AlfredoSystems/I3ESC-Hardware/I3ESC-pdfs/I3ESC.pdf

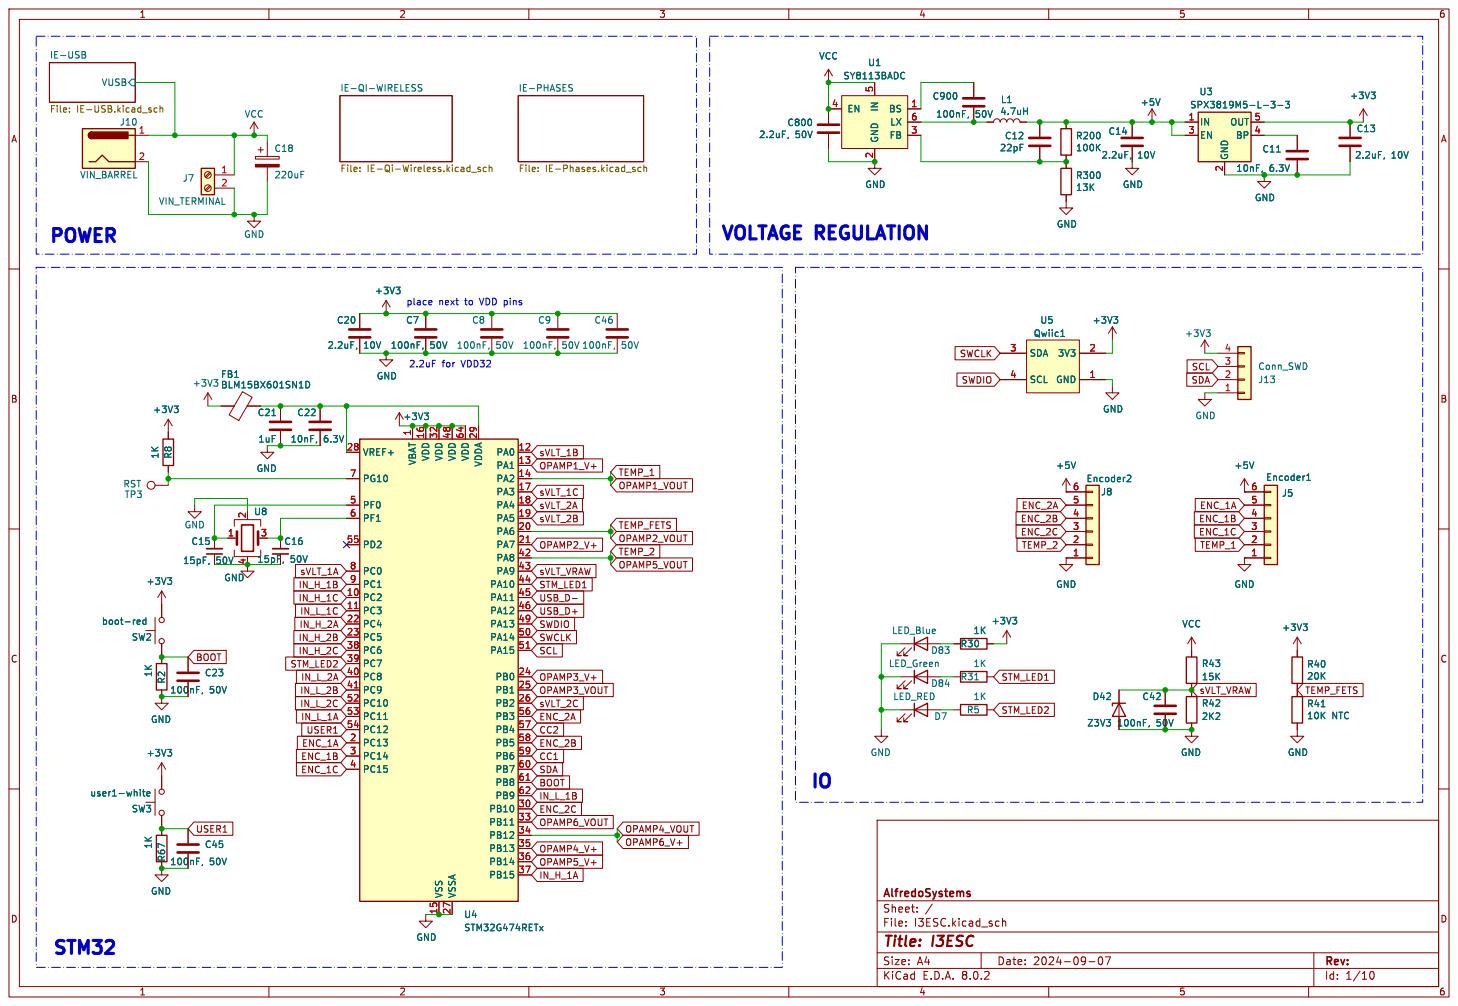
[picture p1: page 1]

File: IE-Phases.kicad_sch VUSB

File: IE-Qi-Wireless.kicad_sch

- change wireless chips to 0603 POWER

1 PC2 10 PC3 11 PA0 12 PA1 13 PA2 14 VSS 15 VDD 16 PA3 17 PA4 18 PA5 19 PC13 2 PA6 20 PA7 21 PC4 22 PC5 23 PB0 24 PB1 25 PB2 26 VSSA 27 VREF+ 28 VDDA 29 PC14 3 PB10 30 VDD 32 PB11 33 PB12 34 PB13 35 PB14 36 PB15 37 PC6 38 PC7 39 PC15 4 PC8 40 PC9 41 PA8 42 PA9 43 PA10 44 PA11 45 PA12 46 VDD 48 PA13 49 PF0 5 PA14 50 PA15 51 PC10 52 PC11 53 PC12 54 PD2 55 PB3 56 PB4 57 PB5 58 PB6 59 PF1 6 PB7 60 PB8 61 PB9 62 VDD 64 PG10 7 PC0 8 PC1 9 C23

1 PC2 10 PC3 11 PA0 12 PA1 13 PA2 14 VSS 15 VDD 16 PA3 17 PA4 18 PA5 19 PC13 2 PA6 20 PA7 21 PC4 22 PC5 23 PB0 24 PB1 25 PB2 26 VSSA 27 VREF+ 28 VDDA 29 PC14 3 PB10 30 VDD 32 PB11 33 PB12 34 PB13 35 PB14 36 PB15 37 PC6 38 PC7 39 PC15 4 PC8 40 PC9 41 PA8 42 PA9 43 PA10 44 PA11 45 PA12 46 VDD 48 PA13 49 PF0 5 PA14 50 PA15 51 PC10 52 PC11 53 PC12 54 PD2 55 PB3 56 PB4 57 PB5 58 PB6 59 PF1 6 PB7 60 PB8 61 PB9 62 VDD 64 PG10 7 PC0 8 PC1 9 U4STM32G474RETx R43

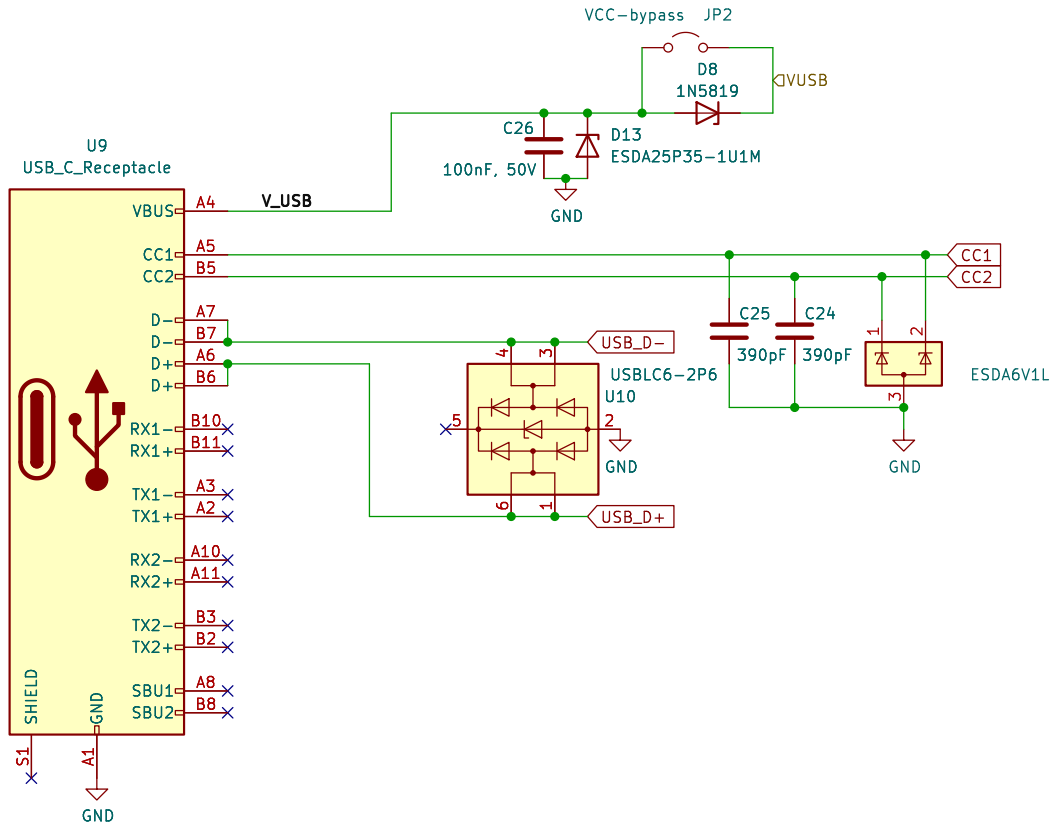
[picture p2: page 2]

File: IE-USB.kicad_sch Sheet: /IE-USB/ AlfredoSystems

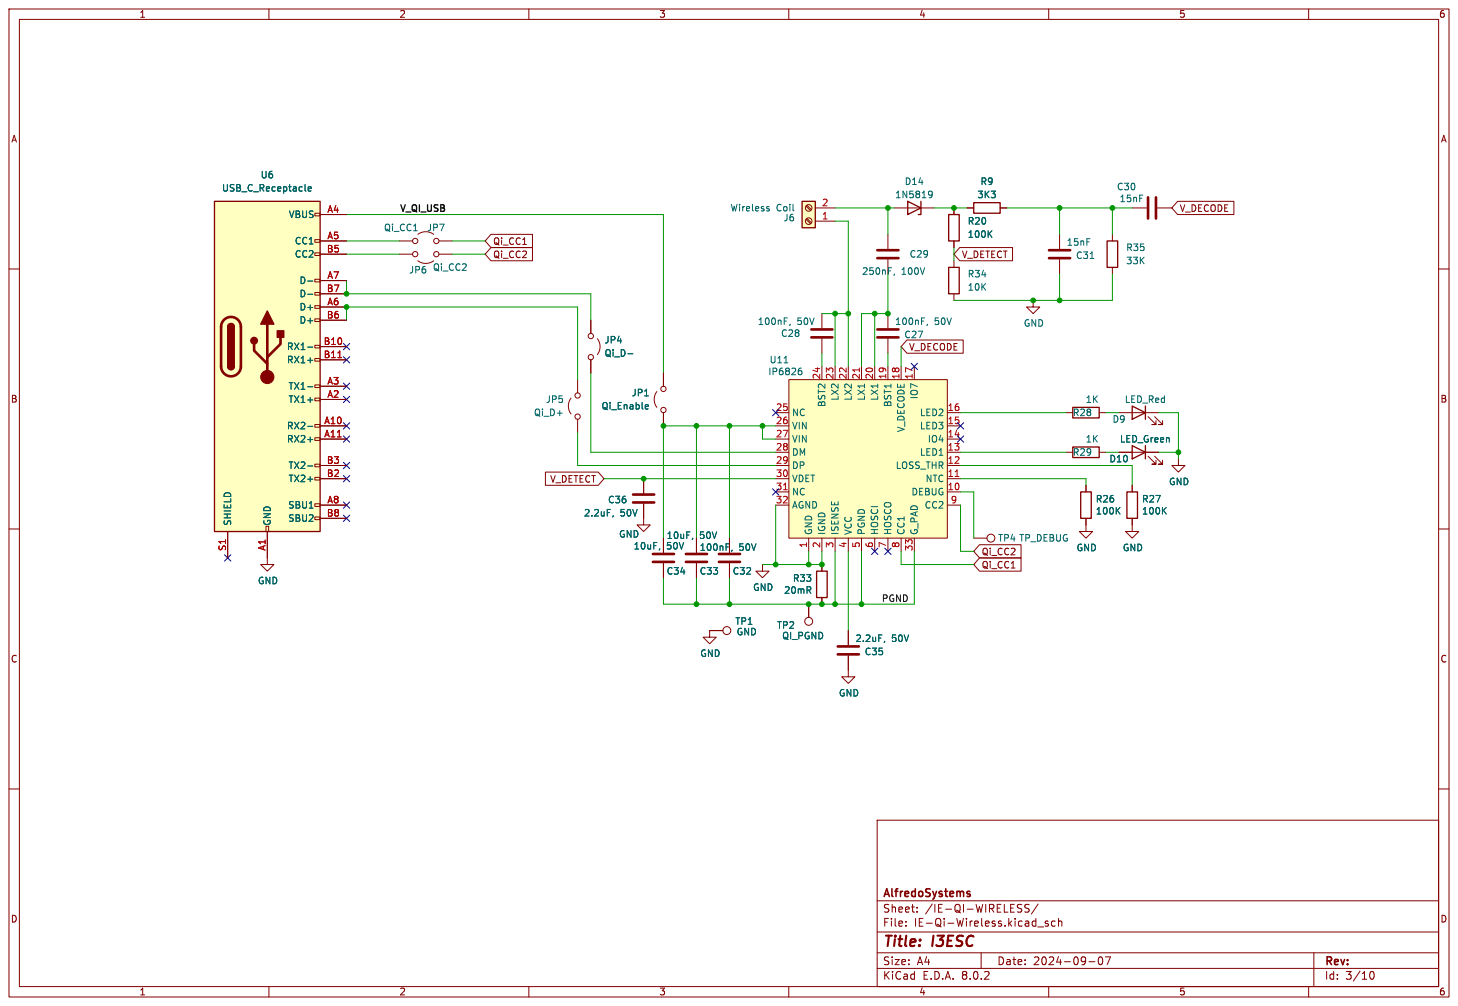
[picture p3: page 3]

2 LX1 20 LX1 21 LX2 22 LX2 23 BST2 24 NC 25 VIN 26 VIN 27 DM 28 DP 29 ISENSE

3 VDET 30 NC 31 AGND 32 G_PAD 33 VCC

AlfredoSystems
File: IE-Qi-Wireless.kicad_sch Sheet: /IE-QI-WIRELESS/
Id: 3/10 Title: I3ESC

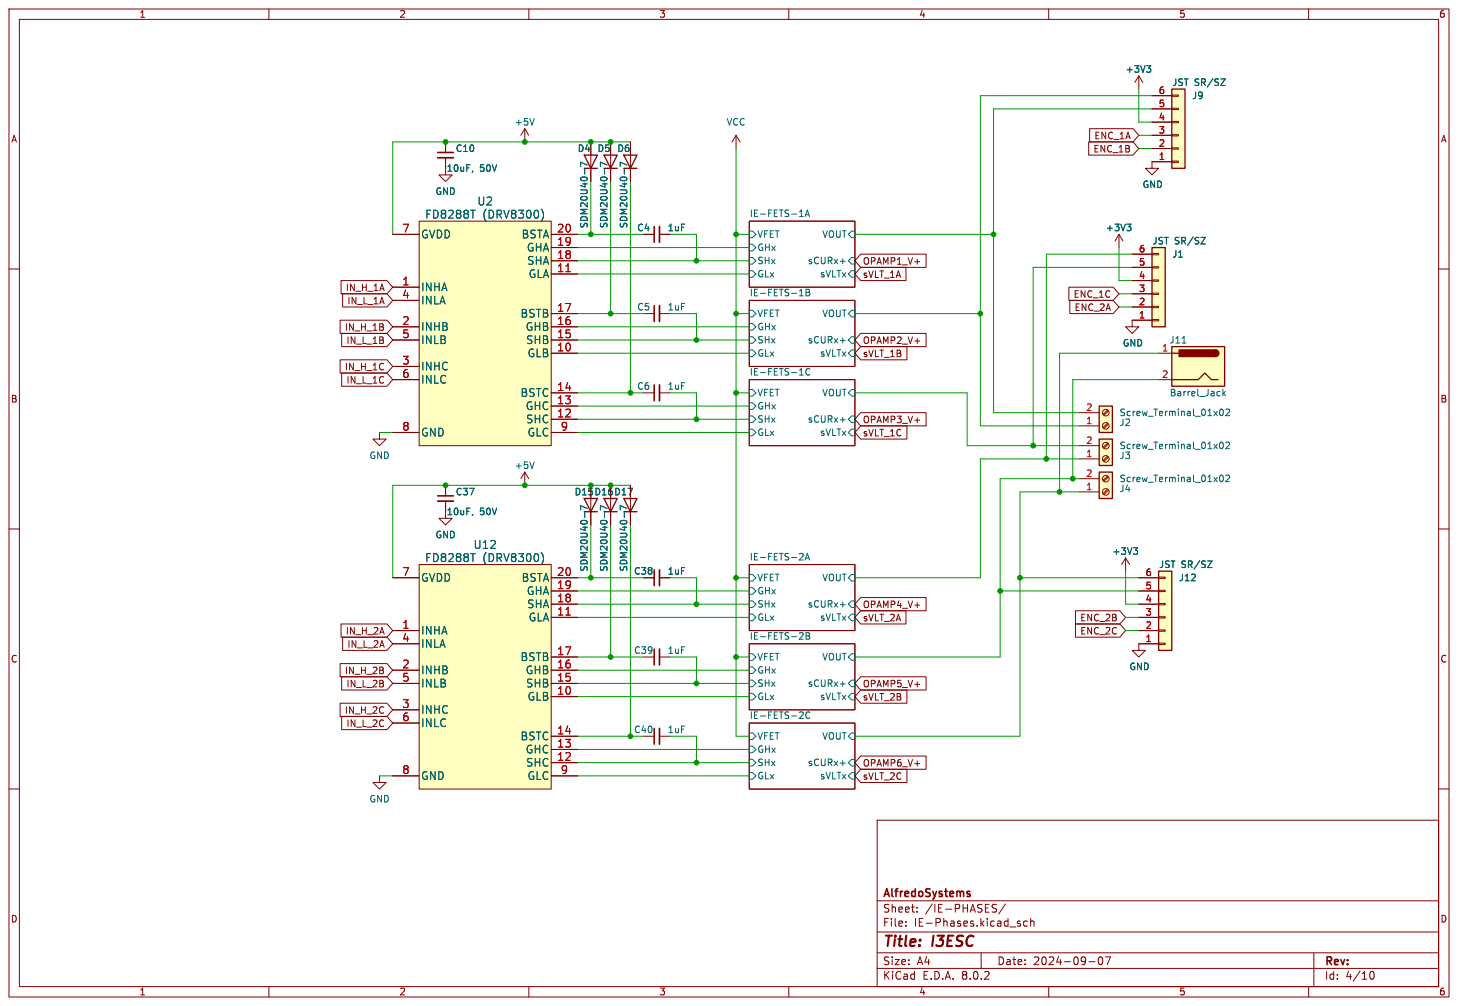
[picture p4: page 4]

JST SR/SZ 123456
JST SR/SZ 123456 GNDGND
JST SR/SZ GND

File: IE-Phases.kicad_sch Sheet: /IE-PHASES/ AlfredoSystems

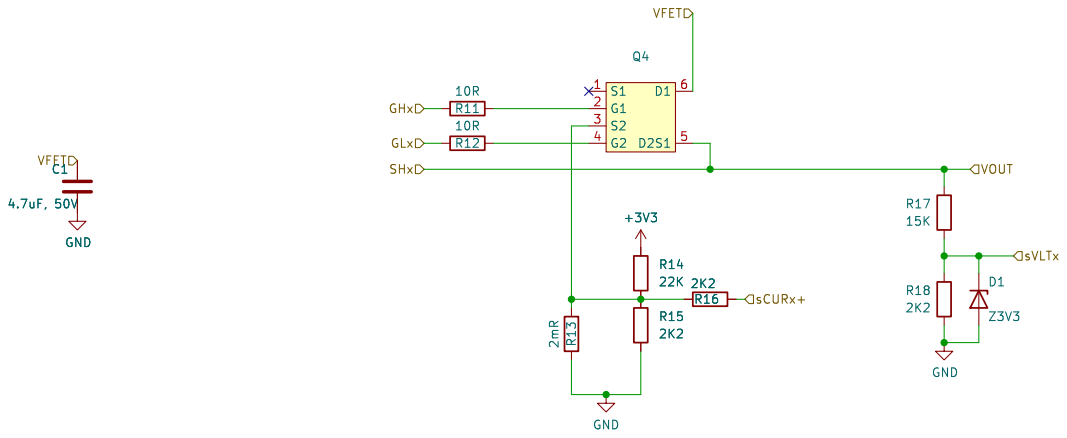
[picture p5: page 5]

File: IE-FETS.kicad_sch Sheet: /IE-PHASES/IE-FETS-1A/ AlfredoSystems R15

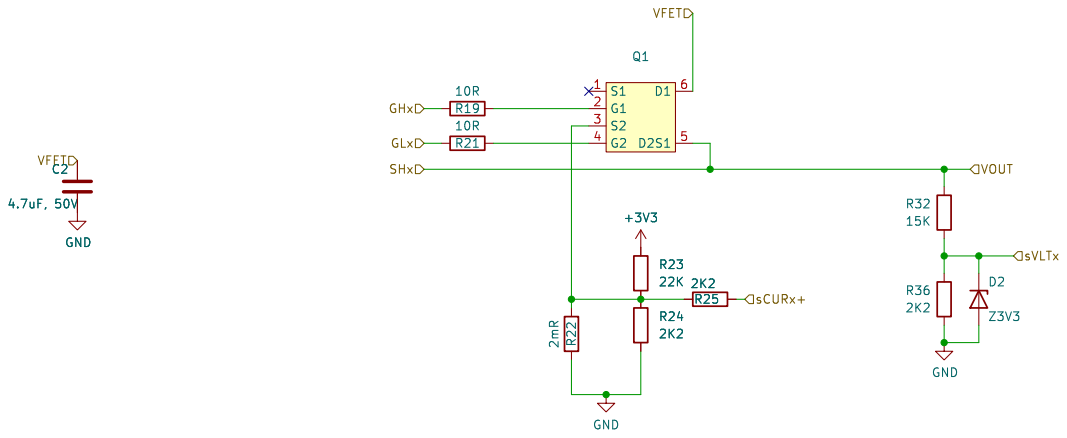
[picture p6: page 6]

File: IE-FETS.kicad_sch Sheet: /IE-PHASES/IE-FETS-1B/ AlfredoSystems R25

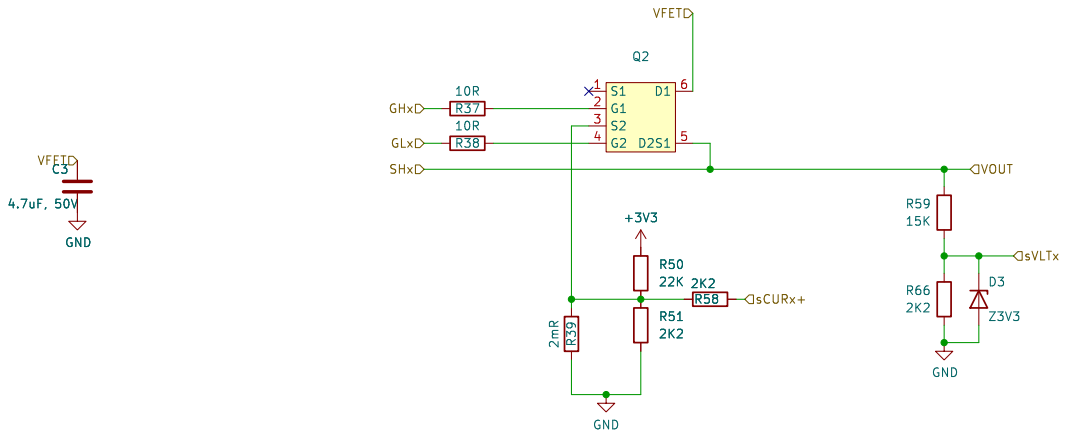
[picture p7: page 7]

File: IE-FETS.kicad_sch Sheet: /IE-PHASES/IE-FETS-1C/ AlfredoSystems

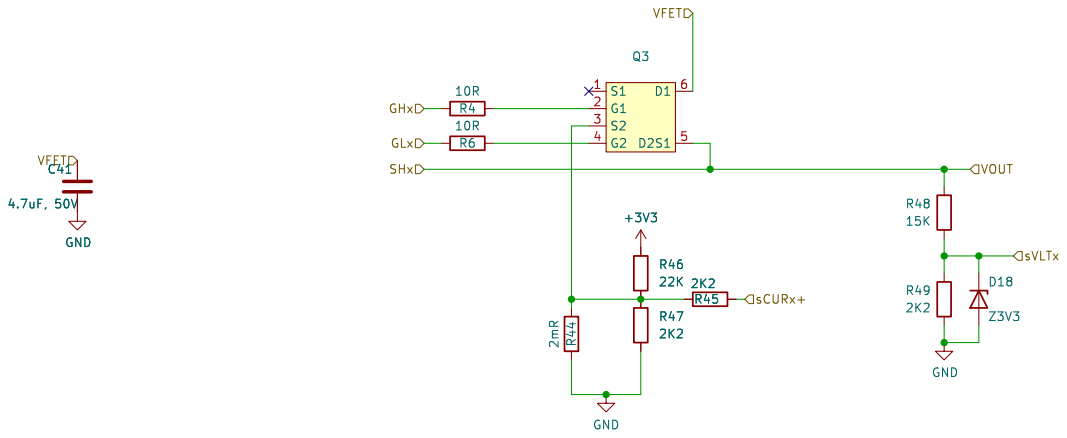
[picture p8: page 8]

File: IE-FETS.kicad_sch Sheet: /IE-PHASES/IE-FETS-2A/ AlfredoSystems R47

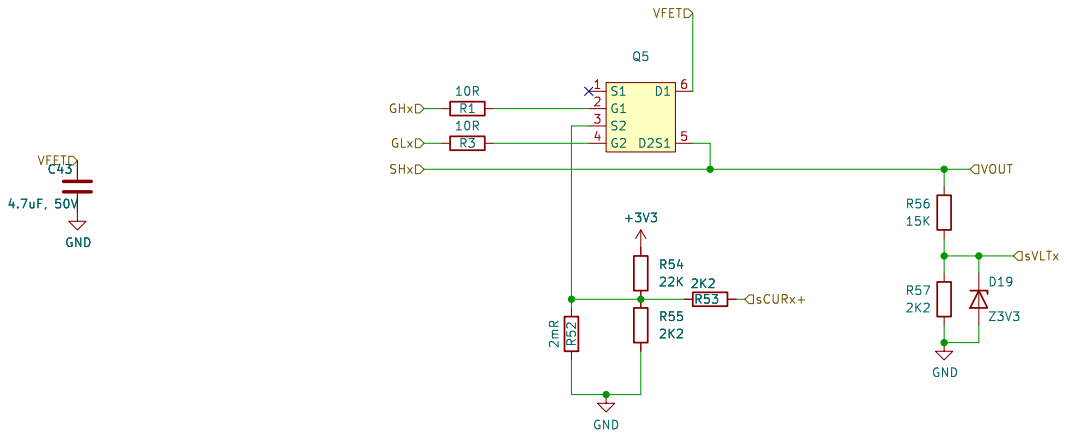
[picture p9: page 9]

File: IE-FETS.kicad_sch Sheet: /IE-PHASES/IE-FETS-2B/ AlfredoSystems R53

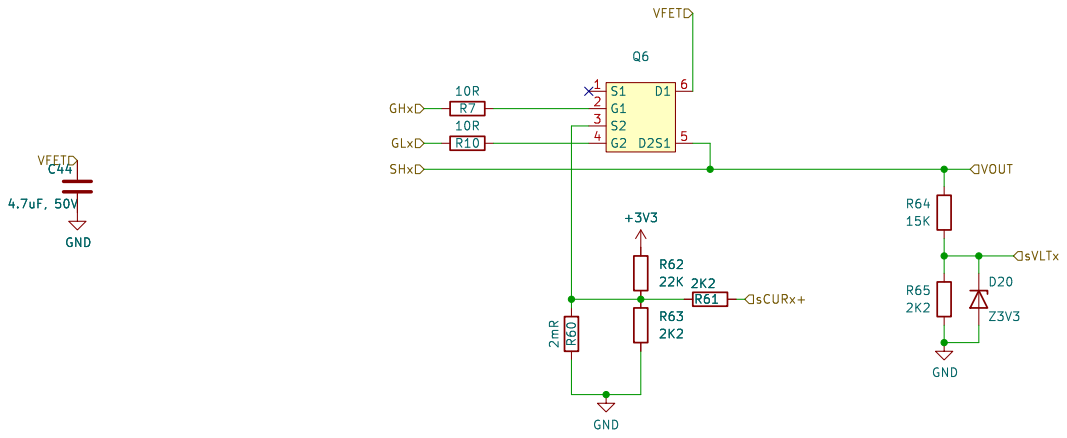
[picture p10: page 10]

File: IE-FETS.kicad_sch Sheet: /IE-PHASES/IE-FETS-2C/ AlfredoSystems
