AlfredoSystems/I3ESC-Hardware/I3ESC.kicad_pcb

## KiCad design I3ESC.kicad_pcb (2026-09-11)

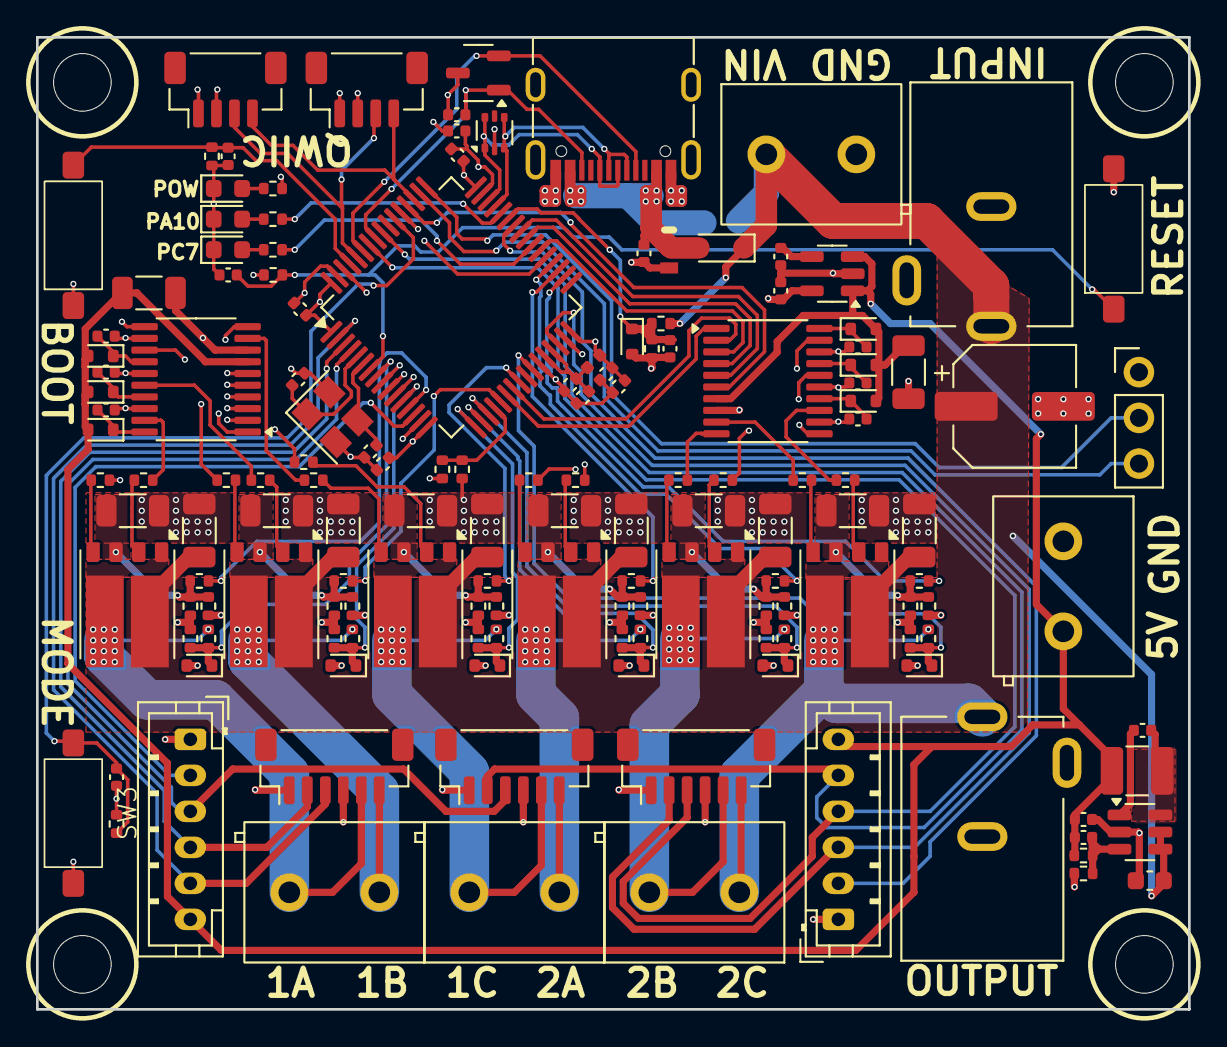
[picture p11: board I3ESC.kicad_pcb from above]

Board: 4 copper layers, 64.0 x 54.0 mm, 155 parts (1 on the bottom side), 104 nets.

Parts:
C1, C2, C3, C41, C43, C44: 4.7uF, 50V; C_1206_3216Metric
C4, C5, C6, C21, C38, C39, C40: 1uF; C_0402_1005Metric
C7, C8, C9, C17, C23, C26, C42, C45, C46, C900: 100nF, 50V; C_0402_1005Metric
C10, C37: 10uF, 50V; C_1206_3216Metric
C11, C22: 10nF, 6.3V; C_0402_1005Metric
C12: 22pF; C_0402_1005Metric
C13, C14, C20: 2.2uF, 10V; C_0402_1005Metric
C15, C16: 15pF, 50V; C_0402_1005Metric
C18: 220uF; CP_Elec_6.3x7.7
C24, C25: 390pF; C_0402_1005Metric
C800: 2.2uF, 50V; C_0603_1608Metric
D1, D2, D3, D18, D19, D20, D42: Z3V3; D_SOD-523
D4, D5, D6, D15, D16, D17: SDM20U40-7; D_SOD-523
D7: LED_RED; LED_0603_1608Metric
D8: 1N5819; D_SOD-323
D11: ESDA6V1L; SOT-23-3
D13: ESDA25P35-1U1M; DFN1610-2
D83: LED_Blue; LED_0603_1608Metric
D84: LED_Yellow; LED_0603_1608Metric
FB1: BLM15BX601SN1D; L_0402_1005Metric
H1, H2, H3, H4: MountingHole; TGD_MountingHole
J1, J9, J12: JST SR/SZ; JST_SH_1x06_Vertical
J2, J3, J4, J6, J7: Screw_Terminal_01x02; TerminalBlock_Ningbo_2P_5mm
J5, J8: Encoder; JST_PH_B6B-PH-K_1x06_P2.00mm_Vertical
J10, J11: VIN_BARREL; DC-005C_1
J13: Conn_01x03; PinHeader_1x03_P2.54mm_Vertical
JP2: VCC-bypass; SolderJumper-2-Small
L1: 4.7uH; L_1210_3225Metric
Q1, Q2, Q3, Q4, Q5, Q6: DFN-8-2EP_6x5mm
R1, R3, R4, R6, R7, R10, R11, R12, R19, R21, R37, R38: 0R; R_0402_1005Metric
R2, R5, R8, R30, R31, R67: 1K; R_0402_1005Metric
R13, R22, R39, R44, R52, R60: 2mR; R_1206_3216Metric
R14, R23, R46, R50, R54, R62: 22K; R_0402_1005Metric
R15, R16, R18, R24, R25, R36, R42, R45, R47, R49, R51, R53, R55, R57, R58, R61, R63, R65, R66: 2K2; R_0402_1005Metric
R17, R32, R43, R48, R56, R59, R64: 15K; R_0402_1005Metric
R40: 20K; R_0402_1005Metric
R41: 10K NTC; R_0402_1005Metric
R200: 100K; R_0402_1005Metric
R300: 13K; R_0402_1005Metric
SW1, SW2, SW3: button; button-3.6x6mm
U1: SY8113BADC; TSOT-23-6
U2, U12: FD8288T (DRV8300); TSSOP-20_4.4x6.5mm_P0.65mm
U3: SPX3819M5-L-3-3; SOT-23-5
U4: STM32G474RETx; LQFP-64_10x10mm_P0.5mm
U5, U11: Qwiic; JST_SH_BM04B-SRSS-TB_1x04-1MP_P1.00mm_Vertical
U8: ABM3B-8.000MHZ; Crystal_SMD_3225-4Pin_3.2x2.5mm
U9: USB_C_Receptacle; USB_TYPE-C-31-M-12
U10: USBLC6-2P6; SOT-666

Connections:
+3V3: C7.1, C8.1, C9.1, C13.2, C20.1, C46.1, FB1.1, J1.4, J9.4, J12.4, R8.2, R14.1, R23.1, R30.1, R40.1, R46.1, R50.1, R54.1, R62.1, SW2.1, SW3.1, U3.5 (OUT), U4.1 (VBAT), U4.16 (VDD), U4.32 (VDD), U4.48 (VDD), U4.64 (VDD), U5.2 (3V3), U11.2 (3V3)
+5V: C10.1, C12.2, C14.2, C37.1, D4.2 (A), D5.2 (A), D6.2 (A), D15.2 (A), D16.2 (A), D17.2 (A), J5.6, J6.2, J8.6, L1.2, R200.1, U2.7 (GVDD), U3.1 (IN), U3.3 (EN), U12.7 (GVDD)
/IE-PHASES/IE-FETS-1A/GHx: R11.2, U2.19 (GHA)
/IE-PHASES/IE-FETS-1A/GLx: R12.2, U2.11 (GLA)
/IE-PHASES/IE-FETS-1A/SHx: C4.2, J2.2, J9.5, Q4.1 (S1), Q4.5 (D2S1), R17.2, U2.18 (SHA)
/IE-PHASES/IE-FETS-1B/GHx: R19.2, U2.16 (GHB)
/IE-PHASES/IE-FETS-1B/GLx: R21.2, U2.10 (GLB)
/IE-PHASES/IE-FETS-1B/SHx: C5.2, J2.1, J9.6, Q1.1 (S1), Q1.5 (D2S1), R32.2, U2.15 (SHB)
/IE-PHASES/IE-FETS-1C/GHx: R37.2, U2.13 (GHC)
/IE-PHASES/IE-FETS-1C/GLx: R38.2, U2.9 (GLC)
/IE-PHASES/IE-FETS-1C/SHx: C6.2, J1.5, J3.2, Q2.1 (S1), Q2.5 (D2S1), R59.2, U2.12 (SHC)
/IE-PHASES/IE-FETS-2A/GHx: R4.2, U12.19 (GHA)
/IE-PHASES/IE-FETS-2A/GLx: R6.2, U12.11 (GLA)
/IE-PHASES/IE-FETS-2A/SHx: C38.2, J1.6, J3.1, Q3.1 (S1), Q3.5 (D2S1), R48.2, U12.18 (SHA)
/IE-PHASES/IE-FETS-2B/GHx: R1.2, U12.16 (GHB)
/IE-PHASES/IE-FETS-2B/GLx: R3.2, U12.10 (GLB)
/IE-PHASES/IE-FETS-2B/SHx: C39.2, J4.2, J12.5, Q5.1 (S1), Q5.5 (D2S1), R56.2, U12.15 (SHB)
/IE-PHASES/IE-FETS-2C/GHx: R7.2, U12.13 (GHC)
/IE-PHASES/IE-FETS-2C/GLx: R10.2, U12.9 (GLC)
/IE-PHASES/IE-FETS-2C/SHx: C40.2, J4.1, J11.1, J12.6, Q6.1 (S1), Q6.5 (D2S1), R64.2, U12.12 (SHC)
/IE-USB/V_USB: C26.1, D8.2 (A), D13.1 (K), JP2.2 (B), U9.A4 (VBUS), U9.A9 (VBUS), U9.B4 (VBUS), U9.B9 (VBUS)
BOOT: C23.1, R2.1, SW2.2, U4.61 (PB8)
CC1: C25.1, D11.2 (K), U4.59 (PB6), U9.A5 (CC1)
CC2: C24.1, D11.1 (K), U4.57 (PB4), U9.B5 (CC2)
ENC_1A: J5.5, J9.3, U4.2 (PC13)
ENC_1B: J5.4, J9.2, U4.3 (PC14)
ENC_1C: J1.3, J5.3, U4.4 (PC15)
ENC_2A: J1.2, J8.5, U4.56 (PB3)
ENC_2B: J8.4, J12.3, U4.58 (PB5)
ENC_2C: J8.3, J12.2, U4.30 (PB10)
GND: C1.2, C2.2, C3.2, C7.2, C8.2, C9.2, C10.2, C11.1, C13.1, C14.1, C15.1, C16.1, C17.2, C18.2, C20.2, C21.2, C22.2, C23.2, C24.2, C25.2, C26.2, C37.2, C41.2, C42.2, C43.2, C44.2, C45.2, C46.2, C800.1, D1.2 (A), D2.2 (A), D3.2 (A), D7.1 (K), D11.3 (A), D13.2 (A), D18.2 (A), D19.2 (A), D20.2 (A), D42.2 (A), D83.1 (K), D84.1 (K), J1.1, J5.1, J6.1, J7.2, J8.1, J9.1, J10.2, J11.2, J12.1, J13.1, R2.2, R13.2, R15.2, R18.1, R22.2, R24.2, R36.1, R39.2, R41.2, R42.1, R44.2, R47.2, R49.1, R51.2, R52.2, R55.2, R57.1, R60.2, R63.2, R65.1, R66.1, R67.2, R300.2, SW1.2, U1.2 (GND), U2.8 (GND), U3.2 (GND), U4.15 (VSS), U4.27 (VSSA), U4.31 (VSS), U4.47 (VSS), U4.63 (VSS), U5.1 (GND), U8.2, U8.4, U9.A1 (GND), U9.A12 (GND), U9.B1 (GND), U9.B12 (GND), U10.2 (GND), U11.1 (GND), U12.8 (GND)
IN_H_1A: U2.1 (INHA), U4.37 (PB15)
IN_H_1B: U2.2 (INHB), U4.9 (PC1)
IN_H_1C: U2.3 (INHC), U4.10 (PC2)
IN_H_2A: U4.22 (PC4), U12.1 (INHA)
IN_H_2B: U4.23 (PC5), U12.2 (INHB)
IN_H_2C: U4.38 (PC6), U12.3 (INHC)
IN_L_1A: U2.4 (INLA), U4.53 (PC11)
IN_L_1B: U2.5 (INLB), U4.62 (PB9)
IN_L_1C: U2.6 (INLC), U4.11 (PC3)
IN_L_2A: U4.40 (PC8), U12.4 (INLA)
IN_L_2B: U4.41 (PC9), U12.5 (INLB)
IN_L_2C: U4.52 (PC10), U12.6 (INLC)
unnamed: C4.1, D4.1 (K), U2.20 (BSTA)
unnamed: C5.1, D5.1 (K), U2.17 (BSTB)
unnamed: C6.1, D6.1 (K), U2.14 (BSTC)
unnamed: D7.2 (A), R5.2
unnamed: C38.1, D15.1 (K), U12.20 (BSTA)
unnamed: C39.1, D16.1 (K), U12.17 (BSTB)
unnamed: C40.1, D17.1 (K), U12.14 (BSTC)
unnamed: D83.2 (A), R30.2
unnamed: D84.2 (A), R31.2
unnamed: Q1.2 (G1), R19.1
unnamed: Q1.4 (G2), R21.1
unnamed: Q1.3 (S2), R22.1, R23.2, R24.1, R25.1
unnamed: Q2.2 (G1), R37.1
unnamed: Q2.4 (G2), R38.1
unnamed: Q2.3 (S2), R39.1, R50.2, R51.1, R58.1
unnamed: Q3.2 (G1), R4.1
unnamed: Q3.4 (G2), R6.1
unnamed: Q3.3 (S2), R44.1, R45.1, R46.2, R47.1
unnamed: Q4.2 (G1), R11.1
unnamed: Q4.4 (G2), R12.1
unnamed: Q4.3 (S2), R13.1, R14.2, R15.1, R16.1
unnamed: Q5.2 (G1), R1.1
unnamed: Q5.4 (G2), R3.1
unnamed: Q5.3 (S2), R52.1, R53.1, R54.2, R55.1
unnamed: Q6.2 (G1), R7.1
unnamed: Q6.4 (G2), R10.1
unnamed: Q6.3 (S2), R60.1, R61.1, R62.2, R63.1
unnamed: C900.2, U1.1 (BS)
unnamed: C12.1, R200.2, R300.1, U1.3 (FB)
unnamed: C900.1, L1.1, U1.6 (LX)
unnamed: C11.2, U3.4 (BP)
unnamed: C15.2, U4.5 (PF0), U8.1
unnamed: C16.2, U4.6 (PF1), U8.3
unnamed: C17.1, R8.1, SW1.1, U4.7 (PG10)
unnamed: C21.1, C22.1, FB1.2, U4.28 (VREF+), U4.29 (VDDA)
OPAMP1_V+: R16.2, U4.13 (PA1)
OPAMP1_VOUT: J5.2, U4.14 (PA2)
OPAMP2_V+: R25.2, U4.21 (PA7)
OPAMP2_VOUT: R40.2, R41.1, U4.20 (PA6)
OPAMP3_V+: R58.2, U4.24 (PB0)
OPAMP4_V+: R45.2, U4.35 (PB13)
OPAMP4_VOUT: R61.2, U4.34 (PB12)
OPAMP5_V+: R53.2, U4.36 (PB14)
OPAMP5_VOUT: J8.2, U4.42 (PA8)
SCL: U4.51 (PA15), U5.4 (SCL), U11.4 (SCL)
SDA: U4.60 (PB7), U5.3 (SDA), U11.3 (SDA)
STM_LED1: R31.1, U4.44 (PA10)
STM_LED2: R5.1, U4.39 (PC7)
SWCLK: J13.3, U4.50 (PA14)
SWDIO: J13.2, U4.49 (PA13)
USB_D+: U4.46 (PA12), U9.A6 (D+), U9.B6 (D+), U10.1 (I/O1), U10.6 (I/O1)
USB_D-: U4.45 (PA11), U9.A7 (D-), U9.B7 (D-), U10.3 (I/O2), U10.4 (I/O2)
USER1: C45.1, R67.1, SW3.2, U4.54 (PC12)
VCC: C1.1, C2.1, C3.1, C18.1, C41.1, C43.1, C44.1, C800.2, D8.1 (K), J7.1, J10.1, JP2.1 (A), Q1.6 (D1), Q2.6 (D1), Q3.6 (D1), Q4.6 (D1), Q5.6 (D1), Q6.6 (D1), R43.2, U1.4 (EN), U1.5 (IN)
sVLT_1A: D1.1 (K), R17.1, R18.2, U4.8 (PC0)
sVLT_1B: D2.1 (K), R32.1, R36.2, U4.12 (PA0)
sVLT_1C: D3.1 (K), R59.1, R66.2, U4.17 (PA3)
sVLT_2A: D18.1 (K), R48.1, R49.2, U4.18 (PA4)
sVLT_2B: D19.1 (K), R56.1, R57.2, U4.19 (PA5)
sVLT_2C: D20.1 (K), R64.1, R65.2, U4.26 (PB2)
sVLT_VRAW: C42.1, D42.1 (K), R42.2, R43.1, U4.43 (PA9)
