AlfredoSystems/I3ESC-Hardware/GoldESC.kicad_pcb

## KiCad design GoldESC.kicad_pcb (2022-11-26)

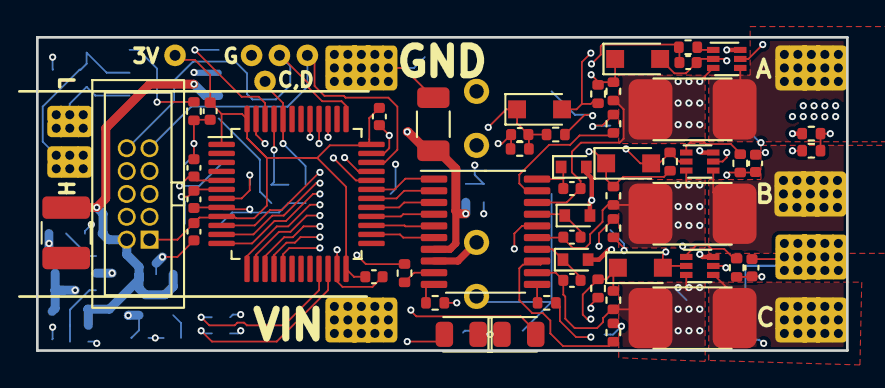
[picture p12: board GoldESC.kicad_pcb from above]

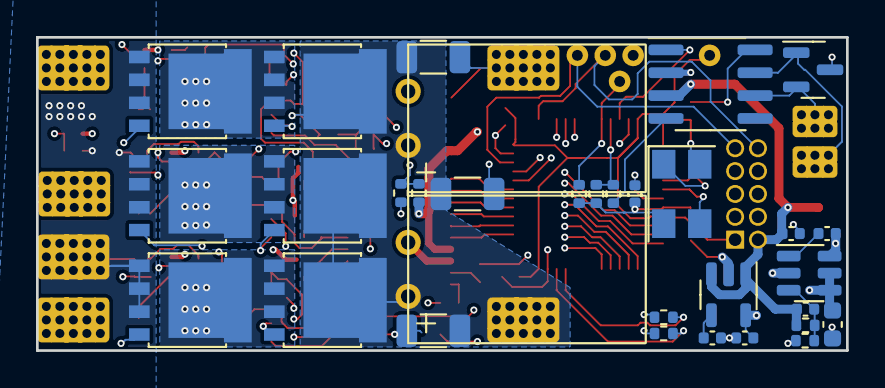
[picture p13: board GoldESC.kicad_pcb from below]

Board: 4 copper layers, 45.0 x 17.4 mm, 97 parts (32 on the bottom side), 68 nets.

Parts:
C1, C2, C3: 4.7uF,50V; C_1206_3216Metric
C4, C5, C6: 1uF; C_0402_1005Metric
C7, C8, C9: 4.7nF; C_0402_1005Metric
C10: 10uF,50V; C_1206_3216Metric
C40, C41: 330uF; Cap_THT_LowESR_330uF
C42, C61, C80: 100nF; C_0402_1005Metric
C52: 10nF, 6.3V; C_0402_1005Metric
C53: 2.2uF, 6.3V; C_0402_1005Metric
C60: 2.2uF, 50V; C_0603_1608Metric
C62: 22pF; C_0402_1005Metric
C63: 22uF, 10V; C_0402_1005Metric
C81, C82, C83, C84: 2.2uF; C_0402_1005Metric
C88, C89: 15pF; C_0402_1005Metric
D1, D2, D3, D42: Z3V3; D_SOD-323_HandSoldering
D4, D5, D6: SDM20U40-7; D_SOD-523
D83: LED_Red; LED_0805_2012Metric
D84: LED_Green; LED_0805_2012Metric
J1, J2, J3: PhaseOut; GE_PwrPad1
J4: GND; GE_PwrPad1
J30: CanOut; GE_SigPad_1x02
J40: Vin; GE_PwrPad1
J41: Gnd; GE_PwrPad1
J81: Conn_02x07_Counter_Clockwise; Connector_2x05_P1.27mm_IDC
L60: 4.7uH; L_1210_3225Metric
Q1, Q2, Q3, Q4, Q5, Q6: YJG150N03A; LFPAK56
R1, R2, R3: 0.5mR; GE_R_2512
R4: 2K; R_0402_1005Metric
R7: 1K; R_0402_1005Metric
R10, R11, R12, R43: 15K; R_0402_1005Metric
R13, R14, R15, R42: 2K2; R_0402_1005Metric
R16, R17, R18: 100R; R_0402_1005Metric
R19, R20, R21, R22, R23, R24: 10R; R_0402_1005Metric
R30: 5.6K; R_0402_1005Metric
R31, R80: 10K; R_0402_1005Metric
R32: 51K; R_0402_1005Metric
R40: 20K; R_0402_1005Metric
R41: 10K NTC; R_0402_1005Metric
R60: 100K; R_0402_1005Metric
R61: 13K; R_0402_1005Metric
R84, R85: 200R; R_0402_1005Metric
TP80, TP81, TP82, TP83, TP84: TestPoint; GE_TestPoint_Loop
U2: FD8288T (DRV8300); TSSOP-20_4.4x6.5mm_P0.65mm
U4, U5, U6: INA185A1; SOT-563
U30: MCP2551-I-SN; SOIC-8_3.9x4.9mm_P1.27mm
U31: CPDT-12V; SOT-23
U50: SPX3819M5-L-3-3; SOT-23-5
U60: SY8113BADC; TSOT-23-6
U80: STM32F103CBTx; LQFP-48_7x7mm_P0.5mm
U81: ABM3B-8.000MHZ; Crystal_SMD_5032-4Pin_5.0x3.2mm

Connections:
+3V3: C53.2, C81.1, C82.1, C83.1, C84.1, J81.1, TP83.1, U50.5 (OUT), U80.1 (VBAT), U80.9 (VDDA), U80.24 (VDD), U80.36 (VDD), U80.48 (VDD)
+5V: C10.1, C62.2, C63.2, D4.2 (A), D5.2 (A), D6.2 (A), J81.2, L60.2, R4.1, R40.1, R60.1, U2.7 (GVDD), U4.6 (VS), U5.6 (VS), U6.6 (VS), U30.3 (VDD), U50.1 (IN), U50.3 (EN)
/GE-Fets-A/GHx: R19.2, U2.19 (GHA)
/GE-Fets-A/GLx: R22.2, U2.11 (GLA)
/GE-Fets-A/REF_1V65: R4.2, R7.1, U4.5 (REF), U5.5 (REF), U6.5 (REF)
/GE-Fets-A/SHx: C4.2, Q1.1 (S), Q1.2 (S), Q1.3 (S), Q4.5 (D), R1.2, R10.2, U2.18 (SHA), U4.3 (IN+)
/GE-Fets-B/GHx: R20.2, U2.16 (GHB)
/GE-Fets-B/GLx: R23.2, U2.10 (GLB)
/GE-Fets-B/SHx: C5.2, Q2.1 (S), Q2.2 (S), Q2.3 (S), Q5.5 (D), R2.2, R11.2, U2.15 (SHB), U5.3 (IN+)
/GE-Fets-C/GHx: R21.2, U2.13 (GHC)
/GE-Fets-C/GLx: R24.2, U2.9 (GLC)
/GE-Fets-C/SHx: C6.2, Q3.1 (S), Q3.2 (S), Q3.3 (S), Q6.5 (D), R3.2, R12.2, U2.12 (SHC), U6.3 (IN+)
CAN_H: J30.2, U30.7 (CANH), U31.1
CAN_L: J30.1, U30.6 (CANL), U31.2
CAN_RX: R30.2, R31.1, U80.45 (PB8)
CAN_TX: U30.1 (TXD), U80.46 (PB9)
GND: C1.2, C2.2, C3.2, C7.1, C8.1, C9.1, C10.2, C40.2, C41.2, C42.2, C52.1, C53.1, C60.1, C63.1, C80.2, C81.2, C82.2, C83.2, C84.2, C88.1, C89.1, D1.2 (A), D2.2 (A), D3.2 (A), D42.2 (A), D83.1 (K), D84.1 (K), J4.1, J41.1, J81.3, Q4.1 (S), Q4.2 (S), Q4.3 (S), Q5.1 (S), Q5.2 (S), Q5.3 (S), Q6.1 (S), Q6.2 (S), Q6.3 (S), R7.2, R13.1, R14.1, R15.1, R31.2, R32.2, R41.2, R42.1, R61.2, R80.2, TP84.1, U2.8 (GND), U4.2 (GND), U5.2 (GND), U6.2 (GND), U30.2 (VSS), U31.3, U50.2 (GND), U60.2 (GND), U80.8 (VSSA), U80.23 (VSS), U80.35 (VSS), U80.47 (VSS), U81.2, U81.4
INHA: U2.1 (INHA), U80.31 (PA10)
INHB: U2.2 (INHB), U80.30 (PA9)
INHC: U2.3 (INHC), U80.29 (PA8)
INLA: U2.4 (INLA), U80.28 (PB15)
INLB: U2.5 (INLB), U80.27 (PB14)
INLC: U2.6 (INLC), U80.26 (PB13)
LimitA: J81.4, U80.39 (PB3)
LimitB: J81.6, U80.40 (PB4)
LimitC: J81.8, U80.41 (PB5)
unnamed: C4.1, D4.1 (K), U2.20 (BSTA)
unnamed: C5.1, D5.1 (K), U2.17 (BSTB)
unnamed: C6.1, D6.1 (K), U2.14 (BSTC)
unnamed: C52.2, U50.4 (BP)
unnamed: C61.1, L60.1, U60.6 (LX)
unnamed: C61.2, U60.1 (BS)
unnamed: C62.1, R60.2, R61.1, U60.3 (FB)
unnamed: C80.1, U80.7 (NRST)
unnamed: C88.2, U80.5 (PD0), U81.1
unnamed: C89.2, U80.6 (PD1), U81.3
unnamed: D83.2 (A), R84.1
unnamed: D84.2 (A), R85.1
unnamed: J1.1, R1.1, U4.4 (IN-)
unnamed: J2.1, R2.1, U5.4 (IN-)
unnamed: J3.1, R3.1, U6.4 (IN-)
unnamed: Q1.4 (G), R19.1
unnamed: Q2.4 (G), R20.1
unnamed: Q3.4 (G), R21.1
unnamed: Q4.4 (G), R22.1
unnamed: Q5.4 (G), R23.1
unnamed: Q6.4 (G), R24.1
unnamed: R16.2, U4.1 (Out)
unnamed: R17.2, U5.1 (Out)
unnamed: R18.2, U6.1 (Out)
unnamed: R30.1, U30.4 (RXD)
unnamed: R32.1, U30.8 (Rs)
unnamed: R80.1, TP80.1, U80.44 (BOOT0)
unnamed: R84.2, U80.21 (PB10)
unnamed: R85.2, U80.22 (PB11)
QuadA_USBDP: J81.7, U80.33 (PA12)
QuadB_USBDM: J81.5, U80.32 (PA11)
SWCLK: J81.10, TP81.1, U80.37 (PA14)
SWDIO: J81.9, TP82.1, U80.34 (PA13)
TEMP_FETS: R40.2, R41.1, U80.13 (PA3)
VDD: C1.1, C2.1, C3.1, C40.1, C41.1, C60.2, J40.1, Q1.5 (D), Q2.5 (D), Q3.5 (D), R43.2, U60.4 (EN), U60.5 (IN)
sCUR_A: C7.2, R16.1, U80.10 (PA0)
sCUR_B: C8.2, R17.1, U80.15 (PA5)
sCUR_C: C9.2, R18.1, U80.16 (PA6)
sVLT_A: D1.1 (K), R10.1, R13.2, U80.11 (PA1)
sVLT_B: D2.1 (K), R11.1, R14.2, U80.14 (PA4)
sVLT_C: D3.1 (K), R12.1, R15.2, U80.17 (PA7)
sVLT_VDD: C42.1, D42.1 (K), R42.2, R43.1, U80.12 (PA2)
