AlfredoSystems/I3ESC-Hardware/(commit log)

2022-05-22 Added fets and drivers, initial critical components selected
    [GE-ESP32-S2.kicad_sch, GE-Fets.kicad_sch, GE-Regs.kicad_sch, GoldESC.kicad_pcb, GoldESC.kicad_sch]
2022-05-24 switched to stm32
    [GE-ESP32-S2.kicad_sch, GE-Fets.kicad_sch, GE-Regs.kicad_sch, GE-STM32F103.kicad_sch, GoldESC.kicad_sch]
2022-05-31 moved the Dsub off-board, most of initial layout routed
    [GE-Fets.kicad_sch, GE-Regs.kicad_sch, GoldESC.kicad_pcb, GoldESC.kicad_sch]
2022-05-31 GoldESC V1 ordered gerbers
    [GoldESC-B_Cu.gbl, GoldESC-B_Mask.gbs, GoldESC-B_Paste.gbp, GoldESC-B_Silkscreen.gbo, GoldESC-Edge_Cuts.gm1, GoldESC-F_Cu.gtl, GoldESC-F_Mask.gts, GoldESC-F_Paste.gtp]
2022-06-05 Updated BOM
    [GE-Fets.kicad_sch, GE-Regs.kicad_sch, GoldESC.kicad_pcb, GoldESC.kicad_sch]
2022-08-28 major schematic and pcb changes for production ready prototype
    [GE-ESP32-S2.kicad_sch, GE-Fets.kicad_sch, GE-Regs.kicad_sch, GE-STM32F103.kicad_sch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]
2022-09-01 First rev of layout before routing
    [GE-Fets.kicad_sch, GE-Regs.kicad_sch, GoldESC.kicad_pcb, GoldESC.kicad_sch]
2022-09-10 all nets routed for next revision, no major drc errors
    [GE-Fets.kicad_sch, GE-Regs.kicad_sch, GoldESC.kicad_pcb, GoldESC.kicad_sch]
2022-09-12 version for 9/10/22 jlc order
    [GE-Fets.kicad_sch, GE-Regs.kicad_sch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]
2022-11-26 updated gitignore
    [GE-Fets.kicad_sch, GE-Regs.kicad_sch, GoldESC.kicad_pcb, GoldESC.kicad_sch]
2024-05-22 initial copy from goldESC
    [GoldESC-CuBottom.gbr, GoldESC-CuIn1.gbr, GoldESC-CuIn2.gbr, GoldESC-CuTop.gbr, GoldESC-EdgeCuts.gbr, GoldESC-MaskBottom.gbr, GoldESC-MaskTop.gbr, GoldESC-NPTH.drl]
2024-05-30 kicad V8
    [I3ESC.kicad_sch, IE-Fets.kicad_sch, IE-Regs.kicad_sch]
2024-06-27 updated with g431 info
    [ExpressLRS-RX.kicad_sch, I3ESC.kicad_pcb, I3ESC.kicad_sch, IE-Fets.kicad_sch]
2024-08-02 push before removing bldc1 external opAmps
    [I3ESC.kicad_pcb, I3ESC.kicad_sch, IE-FETS-NoOp.kicad_sch]
2024-08-08 push for 8/8 order
    [ExpressLRS-RX.kicad_sch, I3ESC.kicad_pcb, I3ESC.kicad_sch, IE-FETS-NoOp.kicad_sch, IE-Fets.kicad_sch]
2024-08-27 first push for v2
    [I3ESC.kicad_pcb, I3ESC.kicad_sch, IE-FETS-NoOp.kicad_sch, IE-Fets.kicad_sch]
2024-09-02 big schematic push for stm32g474
    [I3ESC.kicad_pcb, I3ESC.kicad_sch, IE-FETS-NoOp.kicad_sch, IE-Fets.kicad_sch, OPAMP-PIN-MAP.ods]
2024-09-02 huge layout progress
    [I3ESC.kicad_pcb, I3ESC.kicad_sch]
2024-09-03 majority of routing for V2 completed
    [I3ESC.kicad_pcb, I3ESC.kicad_sch]
2024-09-07 push before schematic cleanup
    [I3ESC.kicad_pcb, I3ESC.kicad_sch, IE-Fets.kicad_sch]
2024-09-07 schematic fix before re-org
    [I3ESC.kicad_pcb, I3ESC.kicad_sch, IE-Fets.kicad_sch, STM32_PINMAP.ods]
2024-09-07 cleaned up all files, created schematic PDF
    [I3ESC.kicad_pcb, I3ESC.kicad_sch, IE-Fets.kicad_sch, IE-Phases.kicad_sch, IE-Qi-Wireless.kicad_sch, IE-USB.kicad_sch, STM32_PINMAP.ods]
2025-10-30 Refactor net naming and update component values
    [I3ESC.kicad_pcb, I3ESC.kicad_sch, IE-Fets.kicad_sch, IE-Phases.kicad_sch]
2026-01-22 Add decoupling capacitor to PG10 and update footprints
    Added C17 (100nF, 50V) capacitor to PG10 for improved decoupling. Updated several footprint and property fields, fixed layer and sheetname attributes, and made minor net and pad stack changes for consistency with KiCAD 9.0. Updated LCSC part number for JST SH connector.
    [I3ESC.kicad_pcb, I3ESC.kicad_sch, IE-Fets.kicad_sch, IE-Phases.kicad_sch, IE-USB.kicad_sch]
2026-07-15 updates for production run 2
    [I3ESC-panelized.kicad_pcb, I3ESC-panelized.kicad_sch, I3ESC.kicad_pcb, I3ESC.kicad_sch, IE-Fets.kicad_sch, IE-Phases.kicad_sch, IE-USB.kicad_sch]
2026-07-24 update for summer 2026 production run
    [I3ESC-panelized.kicad_pcb, I3ESC.kicad_pcb, I3ESC.kicad_sch, IE-Fets.kicad_sch, IE-Phases.kicad_sch]
2026-09-01 production run 4 updates
    [I3ESC-panelized.kicad_pcb, I3ESC.kicad_pcb]
2026-09-11 fixed LCSC Numbers, order 9-10-26
    [I3ESC-panelized.kicad_pcb, I3ESC.kicad_pcb, I3ESC.kicad_sch, IE-Phases.kicad_sch]
2026-09-29 Update .gitignore and untrack lock files and fab backups
    Ignore KiCad local history (.history/), lock files (*.lck), fab plugin backup zips (production*/backups/) and OS junk. Fix the #auto_saved_files# rule, which git was reading as a comment.
